yutotnh/CAN_H-Bridge_Dual_MD/H-Bridge-MD.kicad_pcb

## KiCad design H-Bridge-MD.kicad_pcb (2021-09-21)

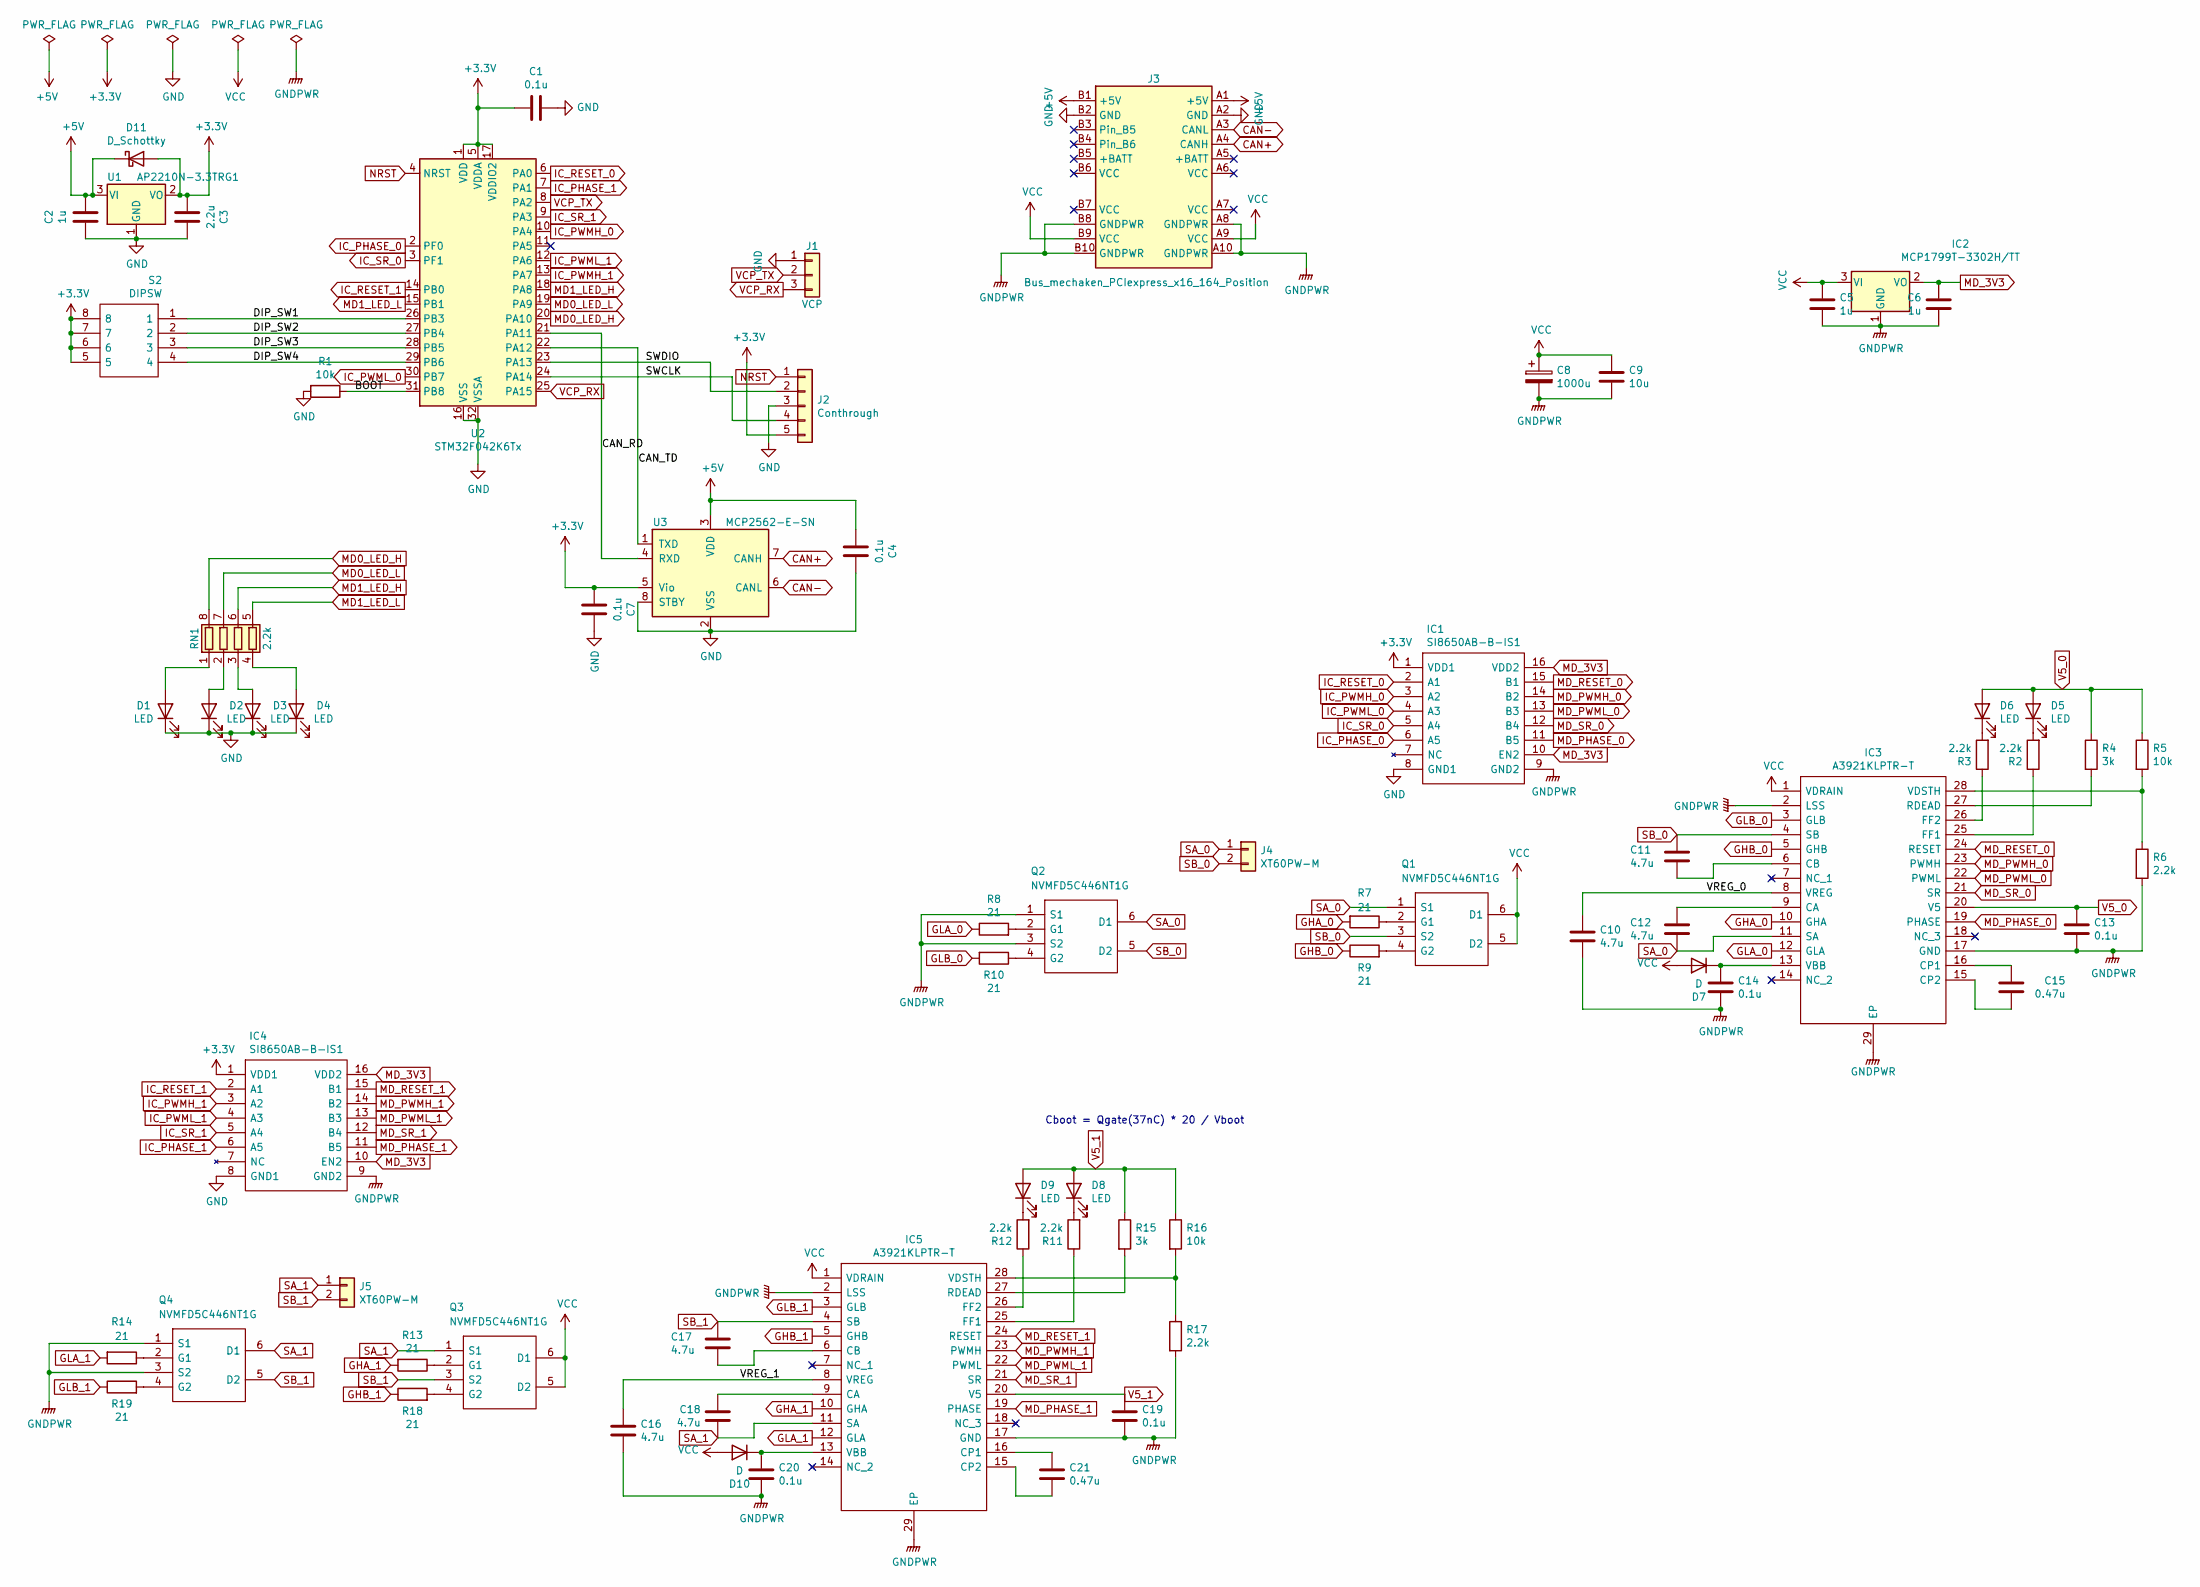
[picture p1: schematic H-Bridge-MD.sch]

Parts:
C1, C4, C7, C13, C14, C19, C20: 0.1u; C_0805_2012Metric
C2, C5, C6: 1u; C_0805_2012Metric
C3: 2.2u; C_0805_2012Metric
C8: 1000u; PinSocket_1x02_P2.54mm_Vertical
C9: 10u; C_0805_2012Metric
C10, C11, C12, C16, C17, C18: 4.7u; C_0805_2012Metric
C15, C21: 0.47u; C_0805_2012Metric
D1, D2, D3, D4, D5, D6, D8, D9: LED; LED_0603_1608Metric_Castellated
D7, D10: D; D_0603_1608Metric
D11: D_Schottky; D_0603_1608Metric
IC1, IC4: SI8650AB-B-IS1; SOIC127P600X175-16N; Mouser Part Number 634-SI8650AB-B-IS1
IC2: MCP1799T-3302H/TT; SOT-23_Handsoldering; Manufacturer_Part_Number MCP1799T-3302H/TT
IC3, IC5: A3921KLPTR-T; SOP65P640X120-29N; Manufacturer_Part_Number A3921KLPTR-T
J1: VCP; PinHeader_1x03_P2.54mm_Vertical
J2: Conthrough; PinHeader_1x05_P2.54mm_Vertical
J3: Bus_mechaken_PCIexpress_x16_164_Position; BUS_mechaken_PCIexpress_x16
J4, J5: XT60PW-M; XT60PW
Q1, Q2, Q3, Q4: NVMFD5C446NT1G; NVMFD5C446NLWFT1G; Mouser Part Number 863-NVMFD5C446NT1G
R1, R5, R16: 10k; R_0603_1608Metric
R2, R3, R6, R11, R12, R17: 2.2k; R_0603_1608Metric
R4, R15: 3k; R_0603_1608Metric
R7, R8, R9, R10, R13, R14, R18, R19: 21; R_0603_1608Metric
RN1: 2.2k; R_Array_Convex_4x1206
S2: DIPSW; SW_DIP_SPSTx04_Slide_9.78x12.34mm_W7.62mm_P2.54mm; Manufacturer_Part_Number IKD0403101
U1: AP2210N-3.3TRG1; SOT-23W_Handsoldering
U2: STM32F042K6Tx; LQFP-32_7x7mm_P0.8mm
U3: MCP2562-E-SN; SOIC-8_3.9x4.9mm_P1.27mm

Connections:
+3V3: C1.2, C3.2, C7.2, D11.2 (A), IC1.1 (VDD1), IC4.1 (VDD1), J2.5, S2.5, S2.6, S2.7, S2.8, U1.2 (VO), U2.1 (VDD), U2.5 (VDDA), U2.17 (VDDIO2), U3.5 (Vio)
+5V: C2.1, C4.2, D11.1 (K), J3.A1 (+5V), J3.B1 (+5V), U1.3 (VI), U3.3 (VDD)
/BOOT: R1.1, U2.31 (PB8)
/CAN_RD: U2.21 (PA11), U3.4 (RXD)
/CAN_TD: U2.22 (PA12), U3.1 (TXD)
/DIP_SW1: S2.1, U2.26 (PB3)
/DIP_SW2: S2.2, U2.27 (PB4)
/DIP_SW3: S2.3, U2.28 (PB5)
/DIP_SW4: S2.4, U2.29 (PB6)
/SWCLK: J2.4, U2.24 (PA14)
/SWDIO: J2.2, U2.23 (PA13)
/VREG_0: C10.1, IC3.8 (VREG)
/VREG_1: C16.1, IC5.8 (VREG)
CAN+: J3.A4 (CANH), U3.7 (CANH)
CAN-: J3.A3 (CANL), U3.6 (CANL)
GHA_0: IC3.10 (GHA), R7.2
GHA_1: IC5.10 (GHA), R13.2
GHB_0: IC3.5 (GHB), R9.1
GHB_1: IC5.5 (GHB), R18.1
GLA_0: IC3.12 (GLA), R8.1
GLA_1: IC5.12 (GLA), R14.2
GLB_0: IC3.3 (GLB), R10.2
GLB_1: IC5.3 (GLB), R19.1
GND: C1.1, C2.2, C3.1, C4.1, C7.1, D1.1 (K), D2.1 (K), D3.1 (K), D4.1 (K), IC1.8 (GND1), IC4.8 (GND1), J1.1, J2.3, J3.A2 (GND), J3.B2 (GND), R1.2, U1.1 (GND), U2.16 (VSS), U2.32 (VSSA), U3.2 (VSS), U3.8 (STBY)
GNDPWR: C5.2, C6.1, C8.2, C9.2, C10.2, C13.2, C14.2, C16.2, C19.2, C20.2, IC1.9 (GND2), IC2.1 (GND), IC3.2 (LSS), IC3.17 (GND), IC3.29 (EP), IC4.9 (GND2), IC5.2 (LSS), IC5.17 (GND), IC5.29 (EP), J3.A8 (GNDPWR), J3.A10 (GNDPWR), J3.B8 (GNDPWR), J3.B10 (GNDPWR), Q2.1 (S1), Q2.3 (S2), Q4.1 (S1), Q4.3 (S2), R6.2, R17.2
IC_PHASE_0: IC1.6 (A5), U2.2 (PF0)
IC_PHASE_1: IC4.6 (A5), U2.7 (PA1)
IC_PWMH_0: IC1.3 (A2), U2.10 (PA4)
IC_PWMH_1: IC4.3 (A2), U2.13 (PA7)
IC_PWML_0: IC1.4 (A3), U2.30 (PB7)
IC_PWML_1: IC4.4 (A3), U2.12 (PA6)
IC_RESET_0: IC1.2 (A1), U2.6 (PA0)
IC_RESET_1: IC4.2 (A1), U2.14 (PB0)
IC_SR_0: IC1.5 (A4), U2.3 (PF1)
IC_SR_1: IC4.5 (A4), U2.9 (PA3)
MD0_LED_H: RN1.8 (R1.2), U2.20 (PA10)
MD0_LED_L: RN1.7 (R2.2), U2.19 (PA9)
MD1_LED_H: RN1.6 (R3.2), U2.18 (PA8)
MD1_LED_L: RN1.5 (R4.2), U2.15 (PB1)
MD_3V3: C6.2, IC1.10 (EN2), IC1.16 (VDD2), IC2.2 (VO), IC4.10 (EN2), IC4.16 (VDD2)
MD_PHASE_0: IC1.11 (B5), IC3.19 (PHASE)
MD_PHASE_1: IC4.11 (B5), IC5.19 (PHASE)
MD_PWMH_0: IC1.14 (B2), IC3.23 (PWMH)
MD_PWMH_1: IC4.14 (B2), IC5.23 (PWMH)
MD_PWML_0: IC1.13 (B3), IC3.22 (PWML)
MD_PWML_1: IC4.13 (B3), IC5.22 (PWML)
MD_RESET_0: IC1.15 (B1), IC3.24 (RESET)
MD_RESET_1: IC4.15 (B1), IC5.24 (RESET)
MD_SR_0: IC1.12 (B4), IC3.21 (SR)
MD_SR_1: IC4.12 (B4), IC5.21 (SR)
NRST: J2.1, U2.4 (NRST)
unnamed: C11.2, IC3.6 (CB)
unnamed: C12.1, IC3.9 (CA)
unnamed: C14.1, D7.1 (K), IC3.13 (VBB)
unnamed: C15.1, IC3.15 (CP2)
unnamed: C15.2, IC3.16 (CP1)
unnamed: C17.2, IC5.6 (CB)
unnamed: C18.2, IC5.9 (CA)
unnamed: C20.1, D10.1 (K), IC5.13 (VBB)
unnamed: C21.1, IC5.15 (CP2)
unnamed: C21.2, IC5.16 (CP1)
unnamed: D1.2 (A), RN1.1 (R1.1)
unnamed: D2.2 (A), RN1.2 (R2.1)
unnamed: D3.2 (A), RN1.3 (R3.1)
unnamed: D4.2 (A), RN1.4 (R4.1)
unnamed: D5.1 (K), R2.2
unnamed: D6.1 (K), R3.2
unnamed: D8.1 (K), R11.2
unnamed: D9.1 (K), R12.2
unnamed: IC3.25 (FF1), R2.1
unnamed: IC3.26 (FF2), R3.1
unnamed: IC3.27 (RDEAD), R4.2
unnamed: IC3.28 (VDSTH), R5.2, R6.1
unnamed: IC5.25 (FF1), R11.1
unnamed: IC5.26 (FF2), R12.1
unnamed: IC5.27 (RDEAD), R15.2
unnamed: IC5.28 (VDSTH), R16.2, R17.1
unnamed: Q1.2 (G1), R7.1
unnamed: Q1.4 (G2), R9.2
unnamed: Q2.2 (G1), R8.2
unnamed: Q2.4 (G2), R10.1
unnamed: Q3.2 (G1), R13.1
unnamed: Q3.4 (G2), R18.2
unnamed: Q4.2 (G1), R14.1
unnamed: Q4.4 (G2), R19.2
SA_0: C12.2, IC3.11 (SA), J4.1, Q1.1 (S1), Q2.6 (D1)
SA_1: C18.1, IC5.11 (SA), J5.1, Q3.1 (S1), Q4.6 (D1)
SB_0: C11.1, IC3.4 (SB), J4.2, Q1.3 (S2), Q2.5 (D2)
SB_1: C17.1, IC5.4 (SB), J5.2, Q3.3 (S2), Q4.5 (D2)
V5_0: C13.1, D5.2 (A), D6.2 (A), IC3.20 (V5), R4.1, R5.1
V5_1: C19.1, D8.2 (A), D9.2 (A), IC5.20 (V5), R15.1, R16.1
VCC: C5.1, C8.1, C9.1, D7.2 (A), D10.2 (A), IC2.3 (VI), IC3.1 (VDRAIN), IC5.1 (VDRAIN), J3.A9 (VCC), J3.B9 (VCC), Q1.5 (D2), Q1.6 (D1), Q3.5 (D2), Q3.6 (D1)
VCP_RX: J1.3, U2.25 (PA15)
VCP_TX: J1.2, U2.8 (PA2)

Notes on the sheet:
Cboot = Qgate(37nC) * 20 / Vboot

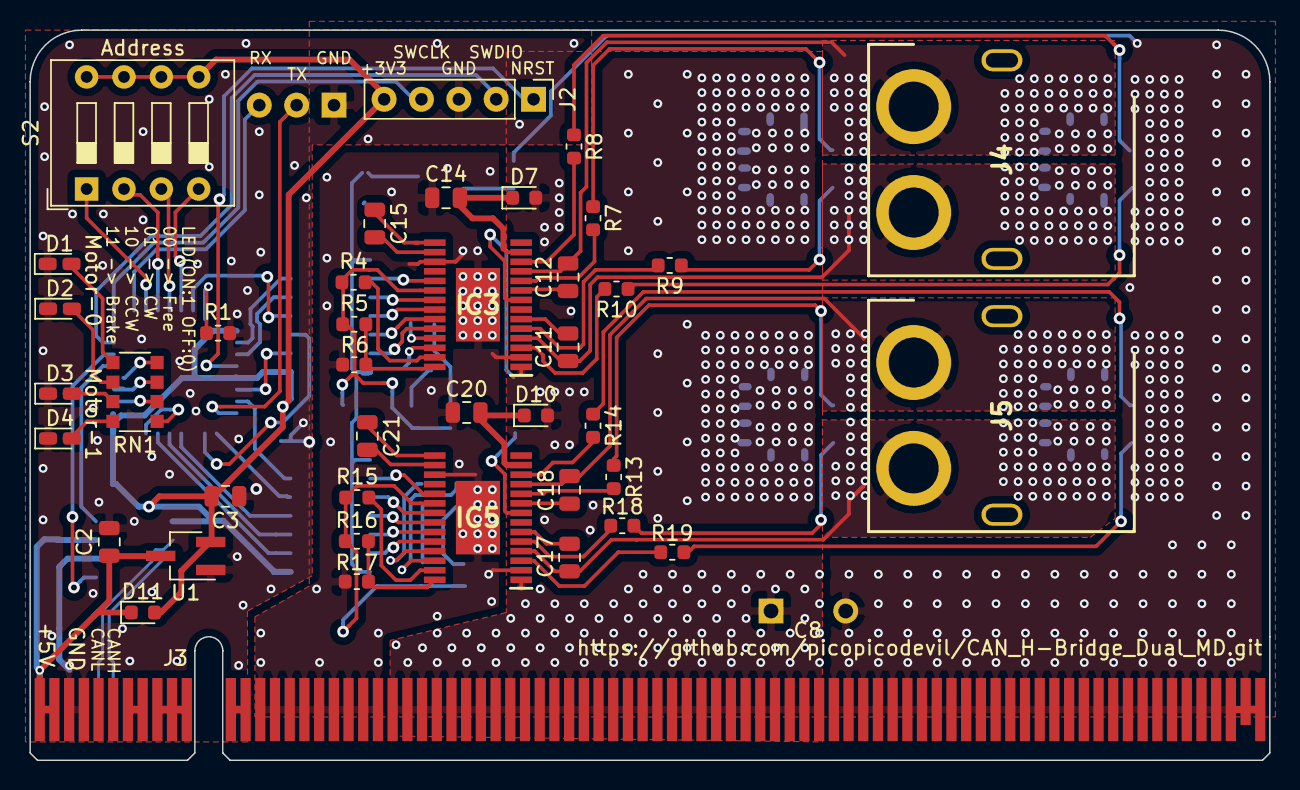
[picture p2: board H-Bridge-MD.kicad_pcb from above]

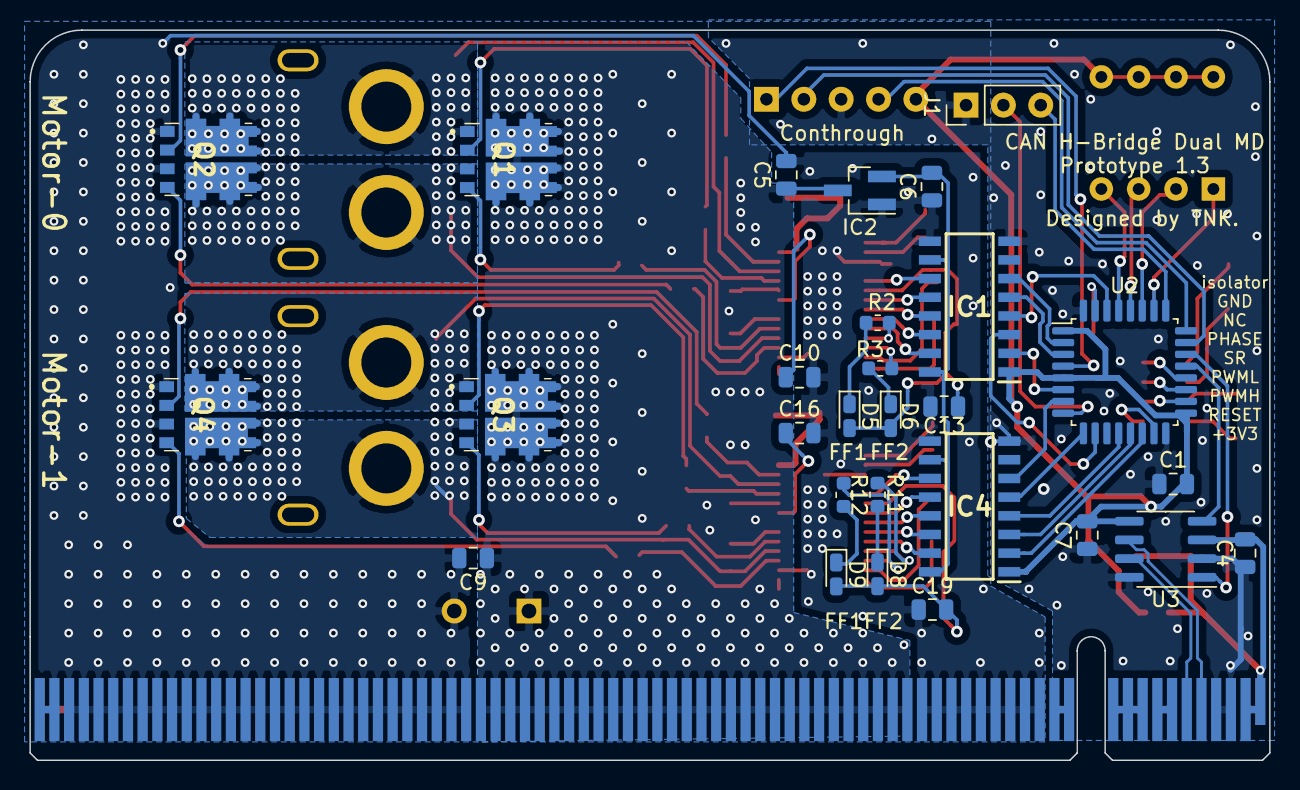
[picture p3: board H-Bridge-MD.kicad_pcb from below]

Board: 2 copper layers, 84.3 x 49.7 mm, 70 parts (29 on the bottom side), 94 nets.
