yutotnh/CAN_H-Bridge_Dual_MD/(commit log)

2019-11-19 Prototype 1.0
    [CAN_Dual_MDexpress-B_Cu.gbl, CAN_Dual_MDexpress-B_Mask.gbs, CAN_Dual_MDexpress-B_SilkS.gbo, CAN_Dual_MDexpress-Edge_Cuts.gm1, CAN_Dual_MDexpress-F_Cu.gtl, CAN_Dual_MDexpress-F_Mask.gts, CAN_Dual_MDexpress-F_SilkS.gto, CAN_Dual_MDexpress-NPTH.drl]
2019-11-19 Prototype 1.1
    change 3.3V regulator & thermal via
    [2018.xlsx, H-Bridge-MD.csv, H-Bridge-MD.kicad_pcb]
2019-12-03 Prototype1.2
    Change: ST-LINK Conn, Rgs, Rg
    [2018.xlsx, CAN_Dual_MDexpress-BOM.xlsx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]
2019-12-04 Prototype1.3
    Change LDO, 0.47uF size
    Correction ST-LINK foot-print
    [H-Bridge-MD.dsn, H-Bridge-MD.kicad_pcb, H-Bridge-MD.sch]
2019-12-07 update
    軽微な配線の修正
    [H-Bridge-MD.kicad_pcb, H-Bridge-MD.sch]
2019-12-10 remove RESET_SW
    [H-Bridge-MD.kicad_pcb, H-Bridge-MD.sch]
2019-12-10 Fix FET via
    [H-Bridge-MD.kicad_pcb]
2019-12-11 add 3V3LDO & pad
    [CAN_Dual_MDexpress-BOM - コピー.xlsx, CAN_Dual_MDexpress-BOM.xlsx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]
2019-12-12 Prototype 1.3
    FusionPCB(12/12)
    [CAN_Dual_MDexpress-BOM - コピー.xlsx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]
2019-12-16 change
    Bootstrap Capacitor 0.1uF -> 4.4uF
    [H-Bridge-MD.sch]
2019-12-17 fix bootstrap capacitor
    [H-Bridge-MD.kicad_pcb, H-Bridge-MD.sch]
2019-12-18 update
    change MD name
    [H-Bridge-MD.kicad_pcb]
2019-12-27 fix
    FF1&FF2 LED
    [H-Bridge-MD.kicad_pcb, H-Bridge-MD.sch]
2019-12-27 fix
    Pcbnewのファイルが見れない問題を修正
    [CAN_Dual_MDexpress-B_Cu.gbl, CAN_Dual_MDexpress-B_Mask.gbs, CAN_Dual_MDexpress-B_SilkS.gbo, CAN_Dual_MDexpress-Edge_Cuts.gm1, CAN_Dual_MDexpress-F_Cu.gtl, CAN_Dual_MDexpress-F_Mask.gts, CAN_Dual_MDexpress-F_SilkS.gto, CAN_Dual_MDexpress.drl]
2020-01-06 change
    書き込み用のピンをコンスルー対応に変更
    [H-Bridge-MD.kicad_pcb, H-Bridge-MD.sch]
2020-01-06 change
    抵抗アレイを1206に変更
    [H-Bridge-MD.kicad_pcb, H-Bridge-MD.sch]
2020-01-06 change
    ダイオードのフットプリントをハーフホール向けに変更
    その他の微修正（主に配線）
    [H-Bridge-MD.kicad_pcb, H-Bridge-MD.sch]
2020-01-07 change
    電解コンデンサを搭載できるように配置を大幅変更
    [H-Bridge-MD.kicad_pcb, H-Bridge-MD.sch]
2020-01-07 change
    シルクを少し変更
2020-01-08 change
    放熱ビアを1mmに変更
    その他大幅な変更
    [H-Bridge-MD.kicad_pcb, H-Bridge-MD.sch, 名前なし.kicad_pcb]
2020-01-10 change
    4pinのDIPスイッチを追加
2020-01-11 change
    FET等の裏表反転
    [H-Bridge-MD.sch, 名前なし2.kicad_pcb]
2020-01-12 change
    電源部のパスコンの追加
    [H-Bridge-MD.kicad_pcb, H-Bridge-MD.sch]
2020-01-12 fix
    Motor0側にあるA3921のVCCにつながるビアを増加
    [H-Bridge-MD.kicad_pcb, H-Bridge-MD.sch]
2020-01-18 change LDO
    アイソレータ用のLDOを変更
    [H-Bridge-MD.sch]
2020-01-19 change
    エッジコネクタ（PCIe）を公式のライブラリを基にしたフットプリントに変更
    [H-Bridge-MD.kicad_pcb, H-Bridge-MD.sch]
2020-01-27 fix
    細かな修正
    [H-Bridge-MD.kicad_pcb, H-Bridge-MD.sch]
2020-01-28 delete file
    X220で生成されてしまったファイルを削除
    [H-Bridge-MD-ThinkPad-X220.kicad_pcb]
2020-02-15 change
    check to elecrow
    [CAN_Dual_MDexpress-BOM.xlsx, H-Bridge-MD.csv, H-Bridge-MD.kicad_pcb, H-Bridge-MD.sch, Template-for-PCBA-Quotation - コピー.xlsx, Template-for-PCBA-Quotation .xlsx]
2020-02-16 change
    3Dデータを関連付け
    [H-Bridge-MD.kicad_pcb, H-Bridge-MD.sch]
2020-02-16 add
    step file
    [H-Bridge-MD.kicad_pcb]
2020-02-17 clean
    シルクを修正
    [H-Bridge-MD.kicad_pcb]
2020-02-17 change
    Si8650のEN2ピンに3.3Vを供給するように変更
    [H-Bridge-MD.kicad_pcb, H-Bridge-MD.sch]
2020-02-21 add
    LDOの逆電圧防止用のSBDを追加
    [H-Bridge-MD.kicad_pcb, H-Bridge-MD.sch]
2020-02-21 fix
    配線のエラーを修正
    [H-Bridge-MD.kicad_pcb, H-Bridge-MD.sch]
2020-02-21 change
    コンスルーの3Dデータ（ピンヘッダ）を消去
    [H-Bridge-MD.kicad_pcb]
2020-02-22 clean
    回路図の配線をわかりやすいように修正
    [H-Bridge-MD.kicad_pcb, H-Bridge-MD.sch]
2020-02-24 change
    XT60の向きを固定
    [H-Bridge-MD.kicad_pcb, H-Bridge-MD.sch]
2020-02-25 change
    許容電流を上げた
    [H-Bridge-MD.kicad_pcb]
2020-02-25 change
    電解コンデンサの位置を修正
    [H-Bridge-MD.kicad_pcb]
2020-02-28 fix
    Hブリッジのゾーンを修正
    [H-Bridge-MD.kicad_pcb]
2020-03-01 fix
    モーターへの配線を容易に行えるよう修正
    [H-Bridge-MD.kicad_pcb]
2020-03-04 clean
    ガーバーデータを出力
    [CAN_Dual_MDexpress-B_Cu.gbl, CAN_Dual_MDexpress-B_Cu.gbr, CAN_Dual_MDexpress-B_Mask.gbr, CAN_Dual_MDexpress-B_Mask.gbs, CAN_Dual_MDexpress-B_Silks.gbo, CAN_Dual_MDexpress-B_Silks.gbr, CAN_Dual_MDexpress-Edge_Cuts.gbr, CAN_Dual_MDexpress-Edge_Cuts.gm1]
2020-06-21 Release
    Release Prototype-1.3
    [CAN_Dual_H-Bridge_MD-B_Cu.gbl, CAN_Dual_H-Bridge_MD-B_Cu.gbr, CAN_Dual_H-Bridge_MD-B_Mask.gbr, CAN_Dual_H-Bridge_MD-B_Mask.gbs, CAN_Dual_H-Bridge_MD-B_Silks.gbo, CAN_Dual_H-Bridge_MD-B_Silks.gbr, CAN_Dual_H-Bridge_MD-Edge_Cuts.gbr, CAN_Dual_H-Bridge_MD-Edge_Cuts.gm1]
2020-06-21 add
    gitignoreを追加
    [CAN_Dual_MDexpress-BOM.xlsx, H-Bridge-MD.csv, Template-for-PCBA-Quotation - コピー.xlsx, Template-for-PCBA-Quotation .xlsx]
2020-06-21 .gitignore is now working
    [CAN_Dual_H-Bridge_MD-B_Cu.gbl, CAN_Dual_H-Bridge_MD-B_Cu.gbr, CAN_Dual_H-Bridge_MD-B_Mask.gbr, CAN_Dual_H-Bridge_MD-B_Mask.gbs, CAN_Dual_H-Bridge_MD-B_Silks.gbo, CAN_Dual_H-Bridge_MD-B_Silks.gbr, CAN_Dual_H-Bridge_MD-Edge_Cuts.gbr, CAN_Dual_H-Bridge_MD-Edge_Cuts.gm1]
2021-09-21 Update: USB TX RXをコンスルーに対応
    [H-Bridge-MD.kicad_pcb]
2021-09-21 Remove: 不要なファイルを削除
    [CAN_Dual_H-Bridge_MD.kicad_pcb]
2021-09-21 Update: SI8650用の3Dモデルのパスを追加
